BertholdBredenkamp/esp32_dbt03/ESP32_C3/Gehäuse/ESP32_C3_DBT03_Gehäuse.png

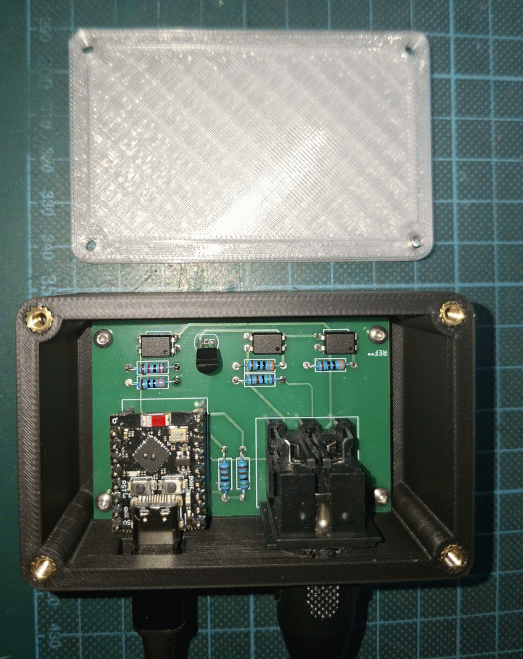
ESP32_C3/Gehäuse/ESP32_C3_DBT03_Gehäuse.png
