BertholdBredenkamp/esp32_dbt03/ESP32_C3/Gehäuse/ESP32_C3_DBT03_Deckel.stl

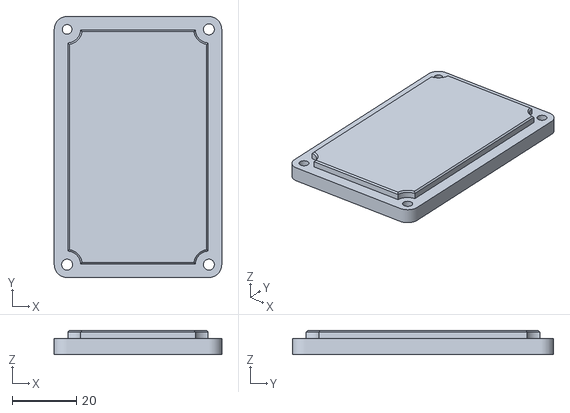
[picture p2: CAD file, 2026-04-14]
ESP32_C3/Gehäuse/ESP32_C3_DBT03_Deckel.stl
52.0 x 81.0 x 7.50
