BertholdBredenkamp/esp32_dbt03/ESP32_C3/KiCad/DBT03-ESP32C3.kicad_pcb

## KiCad design ESP32_C3/KiCad/DBT03-ESP32C3.kicad_pcb (2026-04-07)

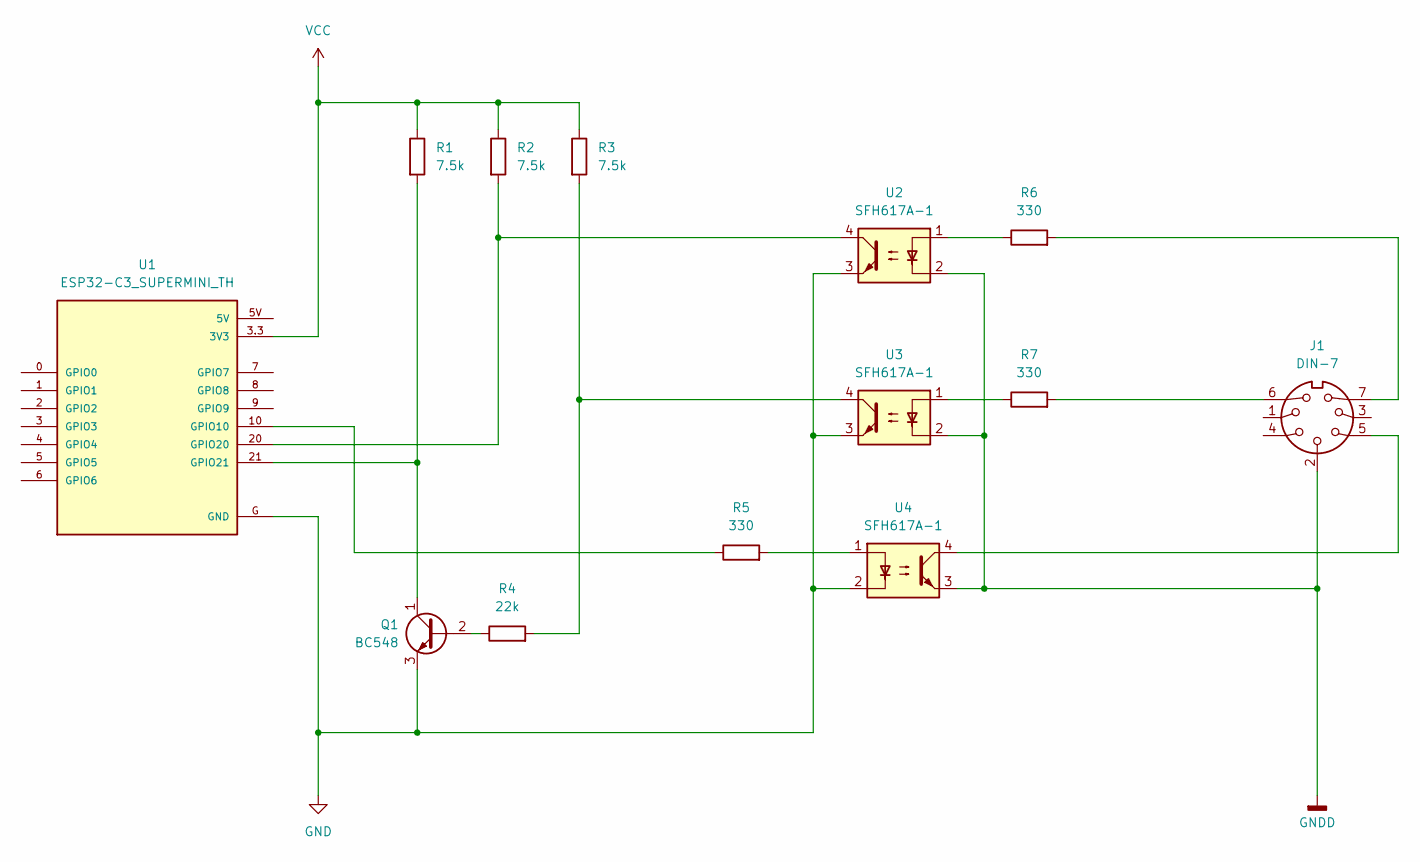
[picture p4: schematic DBT03-ESP32C3.kicad_sch, ESP32_C3_DBT03]

Parts:
J1: DIN-7; DIN_7_Buchse
Q1: BC548; TO-92_Inline
R1, R2, R3: 7.5k; R_Axial_DIN0207_L6.3mm_D2.5mm_P10.16mm_Horizontal
R4: 22k; R_Axial_DIN0207_L6.3mm_D2.5mm_P10.16mm_Horizontal
R5, R6, R7: 330; R_Axial_DIN0207_L6.3mm_D2.5mm_P10.16mm_Horizontal
U1: ESP32-C3_SUPERMINI_TH; MODULE_ESP32-C3_SUPERMINI_TH
U2, U3, U4: SFH617A-1; DIP-4_W7.62mm

Connections:
GND: Q1.3 (E), U1.G (GND), U2.3, U3.3, U4.2
GNDD: J1.2, U2.2, U3.2, U4.3
unnamed: J1.5, U4.4
unnamed: J1.6, R7.2
unnamed: J1.7, R6.2
unnamed: Q1.2 (B), R4.1
unnamed: Q1.1 (C), R1.2, U1.21 (GPIO21)
unnamed: R3.2, R4.2, U3.4
unnamed: R5.2, U4.1
unnamed: R6.1, U2.1
unnamed: R7.1, U3.1
unnamed: R5.1, U1.10 (GPIO10)
unnamed: R2.2, U1.20 (GPIO20), U2.4
VCC: R1.1, R2.1, R3.1, U1.3.3 (3V3)

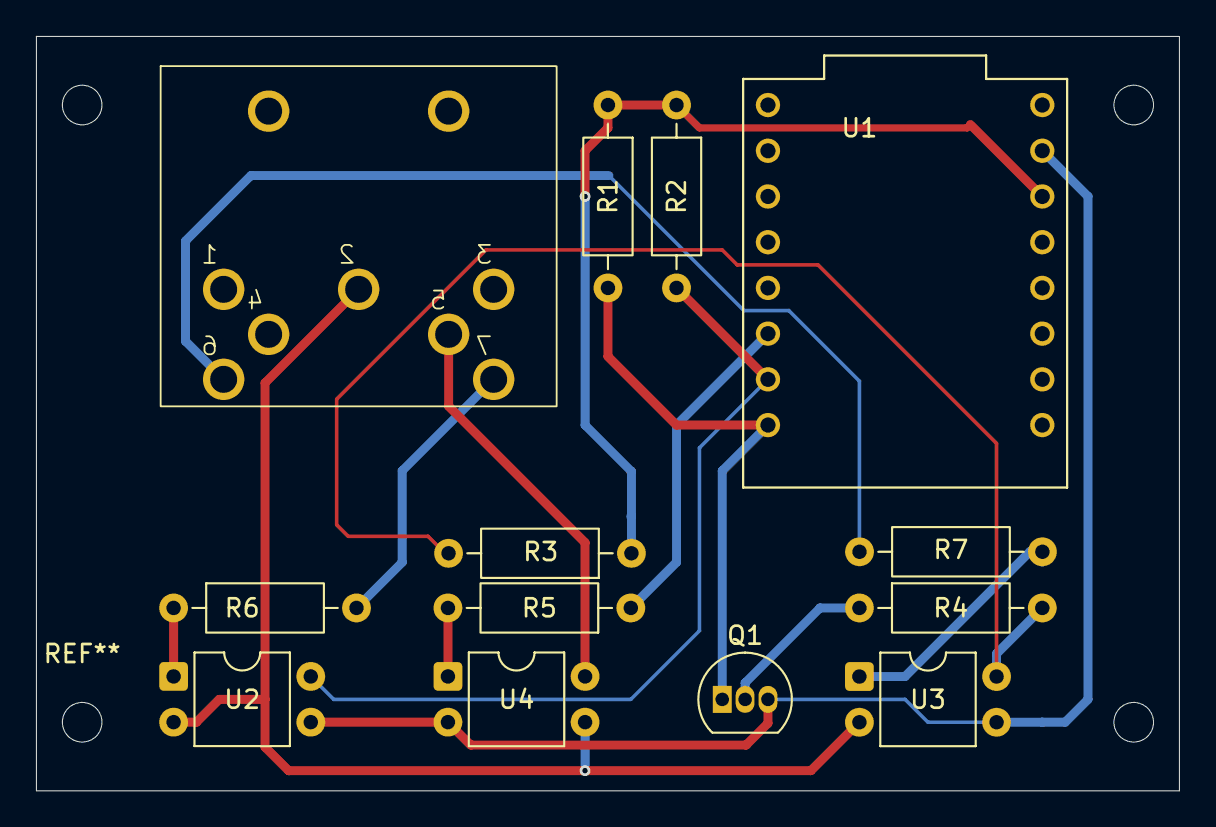
[picture p5: board DBT03-ESP32C3.kicad_pcb from above]

Board: 2 copper layers, 63.5 x 41.9 mm, 13 parts (0 on the bottom side), 14 nets.
