BertholdBredenkamp/esp32_dbt03/KiCad/ESP-DBT03.kicad_sch

## KiCad design KiCad/ESP-DBT03.kicad_sch (2025-11-08)

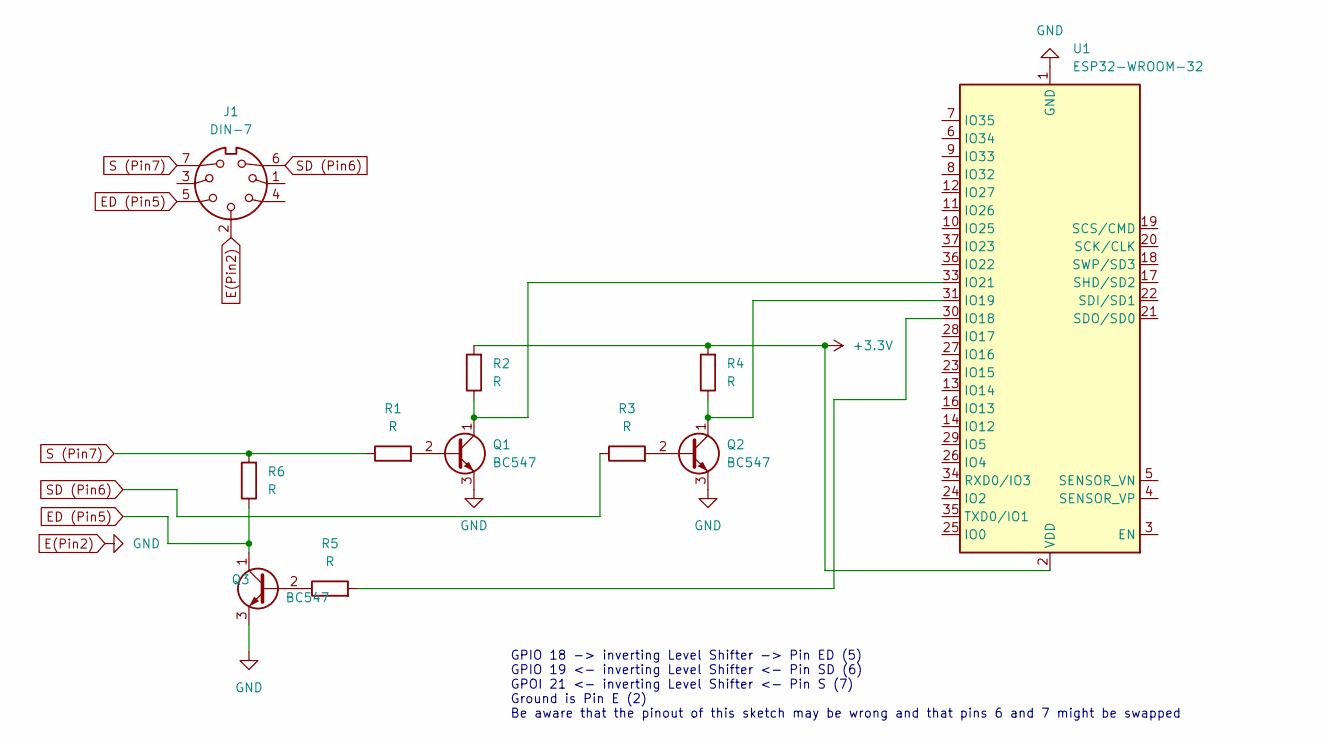
[picture p6: schematic ESP-DBT03.kicad_sch]

Parts:
J1: DIN-7; PinSocket_1x07_P2.54mm_Vertical
Q1, Q2, Q3: BC547; TO-92_Inline
R1, R2, R3, R4, R5, R6: R; R_Axial_DIN0204_L3.6mm_D1.6mm_P5.08mm_Horizontal
U1: ESP32-WROOM-32

Connections:
+3.3V: R2.2, R4.2, U1.2 (VDD)
E(Pin2): J1.2, Q1.3 (E), Q2.3 (E), Q3.3 (E), U1.1 (GND), U1.15 (GND), U1.38 (GND), U1.39 (GND)
ED (Pin5): J1.5, Q3.1 (C), R6.1
unnamed: Q1.1 (C), R2.1, U1.33 (IO21)
unnamed: Q1.2 (B), R1.2
unnamed: Q2.1 (C), R4.1, U1.31 (IO19)
unnamed: Q2.2 (B), R3.2
unnamed: Q3.2 (B), R5.1
unnamed: R5.2, U1.30 (IO18)
S (Pin7): J1.7, R1.1, R6.2
SD (Pin6): J1.6, R3.1

Notes on the sheet:
GPIO 18 -> inverting Level Shifter -> Pin ED (5) GPIO 19 <- inverting Level Shifter <- Pin SD (6) GPOI 21 <- inverting Level Shifter <- Pin S (7) Ground is Pin E (2) Be aware that the pinout of this sketch may be wrong and that pins 6 and 7 might be swapped
