BertholdBredenkamp/esp32_dbt03/ESP32_C3/firmware/esp32-c3_dbt03.ino

/* Hello World Example

   This example code is in the Public Domain (or CC0 licensed, at your option.)

   Unless required by applicable law or agreed to in writing, this
   software is distributed on an "AS IS" BASIS, WITHOUT WARRANTIES OR
   CONDITIONS OF ANY KIND, either express or implied.
*/

// Board : ESP32C3 Dev Module
// 

#include <Arduino.h>
#include <stdio.h>
#include "freertos/FreeRTOS.h"
#include "freertos/task.h"
#include "freertos/event_groups.h"
#include "esp_system.h"
#include "esp_log.h"
#include "esp_sleep.h"
#include "esp_spi_flash.h"
#include "esp_log.h"
#include "nvs_flash.h"

#include <string.h>

#define CORE_DEBUG_LEVEL 4
#define LOG_LOCAL_LEVEL CORE_DEBUG_LEVEL 
#include <esp32-hal-log.h>


extern "C" {
#include "applications.h"
#include "settings.h"
#include "interfaces.h"
#include "if_dbt03.h"
#include "wlan.h"
}

// void settings_init();
void terminal_task(void *pvParameters);


void setup()
{
	printf("Hello world!\n");

	// Serial.begin(115200);
  delay(2000);
  // Serial.print("Waiting for 5... ");


	//Initialize NVS
	esp_err_t ret = nvs_flash_init();
	// ESP_ERROR_CHECK(nvs_flash_erase());
	if (ret == ESP_ERR_NVS_NO_FREE_PAGES || ret == ESP_ERR_NVS_NEW_VERSION_FOUND) {
		ESP_ERROR_CHECK(nvs_flash_erase());
		ret = nvs_flash_init();
	}

	ESP_ERROR_CHECK(ret);
  printf("Bre Start Init 1\n");
	settings_init();
	printf("Bre Ende Init 1\n");
	wifi_init_sta();
  printf("\nBre WLAN Start Ende Init 1\n");
  delay(2000);
	xTaskCreate(terminal_task, "dbt03", 4096, &if_dbt03 , 5, NULL);

	while (1==1){
	//	printf("500 ms delay\n");
		vTaskDelay(500/portTICK_PERIOD_MS);
	}

	printf("Restarting now.\n");
	fflush(stdout);
	//esp_restart();
}


void loop() {

}
