BertholdBredenkamp/esp32_dbt03/(commit log)

2025-11-08 Adding KiCad Schematic (#5)
    * Create ESP-DBT03.sch
    * Add KiCad schematic
    Adding The Schmatics as a Kicad File
    * Delete KiCad/ESP-DBT03.sch
    [ESP-DBT03.kicad_sch]
2026-04-07 ESP32_C3 firmware und KiCad hinzugefügt
    Anpassung an Arduino und ESP32_C3
    [DBT03-ESP32C3.kicad_pcb, DBT03-ESP32C3.kicad_sch]
2026-04-09 Readme hinzugefügt
    [DBT03-ESP32C3.csv]
2026-04-14 Gehäuse STL hinzugefügt
    Gehäuse 3D Druck
    [ESP32_C3_DBT03_Deckel.stl, ESP32_C3_DBT03_Körper.stl]
2026-04-18 Anpassung HostName
    Erweiterung der Einstellungen um den Host Namen
    [ESP32_C3_DBT03_Deckel.stl, ESP32_C3_DBT03_Körper.stl]
